eSpark-Backup/cwa-tracker-hw/Design-Files/Tracker-NB-IOT-PMIC-v1.1/Deliverables/_Renderings/2D_Top_View.png

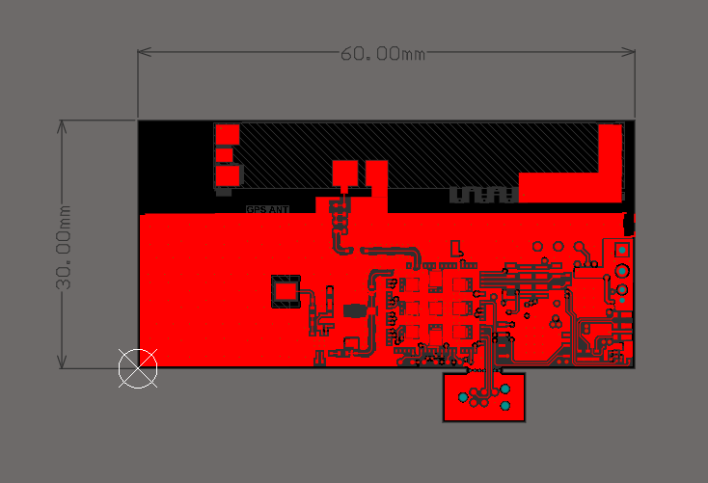
Design-Files/Tracker-NB-IOT-PMIC-v1.1/Deliverables/_Renderings/2D_Top_View.png
