eSpark-Backup/cwa-tracker-hw/Design-Files/Tracker-NB-IOT-PMIC-v1.1/Deliverables/_Renderings/3D_Isometric_View2.png

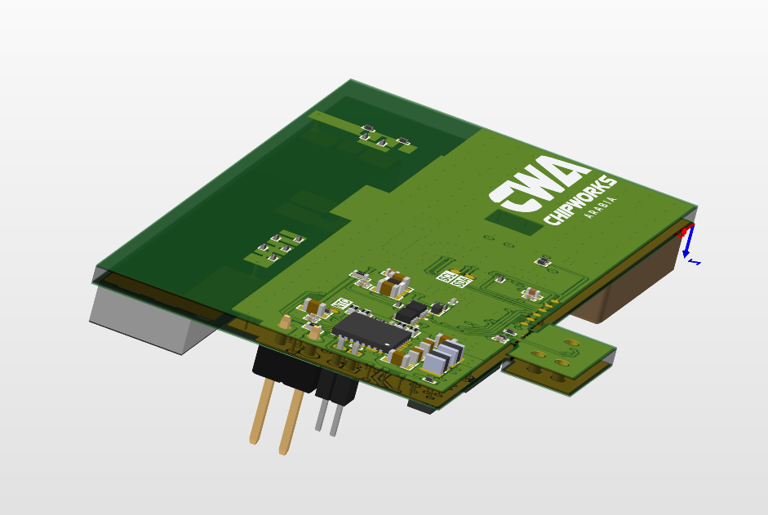
Design-Files/Tracker-NB-IOT-PMIC-v1.1/Deliverables/_Renderings/3D_Isometric_View2.png
