eSpark-Backup/cwa-tracker-hw/Design-Files/Tracker-NB-IOT-PMIC-v1.1/Deliverables/BOM/Tracker-NB-IOT-v1.1.xlsx

# | Item Type | Designator | Description | Footprint | Manufacturer Part Number | Manufacturer | Value | Quantity | Link | Remarks
1 | ANTENNA | A1 | GPS SMT PATCH ANTENNA | DSGP.1575.18.4.A.02 | DSGP.1575.18.4.C.02 | Taoglas | DSGP.1575.18.4.A.02 | 1
2 | RF Antennas | ANT1 | RF ANT 700MHZ/750MHZ FLAT BAR | P822601 | P822601 | AVX | P822601 | 1
3 | Capacitor | C1, C2, C3 | CAP CER 39PF 50V C0G/NPO 0402 | Cap-0402 | CC0402FRNPO9BN390 | Yageo | 39pF | 3
4 | Capacitor | C4, C5 | CAP CER 39PF 50V C0G/NPO 0402 | Cap-0402 | CC0402FRNPO9BN390 | Yageo | DNP | 2
5 | Capacitors | C6, C14 | CAP CER 100PF 50V C0G/NPO 0201 | CAP-0201 | CC0201GRNPO9BN101 | Yageo | 100pF | 2
6 | Capacitors | C7, C13, C17, C20, C21, C30, C31 | CAP CER 0.1UF 10V X5R 0201 | CAP-0201 | CC0201KRX5R6BB104 | Yageo | 100nF | 7
7 | Capacitor | C8, C9, C22, C23 | CAP CER 1UF 10V X5R 0201 | CAP-0201 | CC0201MRX5R6BB105 | Yageo | 1uF | 4
8 | Capacitor | C10, C11, C24, C25, C26, C28, C29 | CAP CER 10UF 10V X7R 0603 | Cap-0603 | GRM188Z71A106KA73D | Murata | 10uF | 7
9 | Capacitor | C12 | CAP CER 3.5PF 50V C0G/NP0 0201 | CAP-0201 | GJM0335C1H3R5BB01D | Murata | 3.5pF | 1
10 | Capacitors | C15, C16, C32 | CAP CER 56PF 25V C0G/NP0 0201 | CAP-0201 | GCM0335C1E560JA16D | Murata | DNP | 3
11 | Capacitors | C18, C19, C27 | CAP CER 4.7UF 10V X5R 0402 | Cap-0402 | CC0402KRX5R6BB475 | Yageo | 4.7uF | 3
12 | Ferrite Beads | FB1 | FERRITE BEAD 120 OHM 0402 1LN | IND-0402 | BLM15EX121SN1D | Murata | BLM15EX121SN1D | 1
13 | Ferrite Beads | FB2 | FERRITE BEAD 22 OHM 0603 1LN | IND-0603 (1608 Metric) | BLM18SD220SN1D | Murata | BLM18SD220SN1D | 1
14 | UFL Connector | J1 | CONN U.FL RCPT STR 50 OHM SMD | U.FL-R-SMT-1(80)_ | U.FL-R-SMT-1(80) | Hirose | U.FL-R-SMT-1(80) | 1
15 | RF / Coaxial Connectors | J2 | CONN SWF RCPT STR 50 OHM SMD | MM8130-2600RA2 | MM8130-2600RA2 | Murata | MM8130-2600RA2 | 1
16 | Male Header | J3 | Gold 250V 3A Straight Square Pins 2.5mm 2P 260℃ 6mm -40℃~+105℃ 3mm 2.54mm Plugin Black Brass 1x2P Plugin,P=2.54mm Pin Headers ROHS | HDR1X2_ | X6511WV-02H-C60D30 | XKB | X6511WV-02H-C60D30 | 1
17 |  | J4 |  | TC2030-IDC-NL_ |  |  | TC2030-IDC-NL | 1
18 | Pogo Connector | J5 | Pogo Pad 2.5mm 4 Pin | Pogo 4 Pin | POGO Connector 4 Pin |  | POGO Connector 4 Pin | 1
19 | Male | J6 | 3A Direct Insert Policy 1.7mm 2P 3mm -55℃~+105℃ 2.5mm 1.27mm Single Row Black Brass 1x2P Plugin,P=1.27mm Pin Headers ROHS | HDR 1x2 Male 1.27mm | 1.27-1*2P | BOOMELE(BOOM Precision Elec) | 1.27-1*2P | 1
20 | Inductor | L1 | FIXED IND 68NH 140MA 1.96OHM SMD | IND-0402 | LQW15AN68NG00D | Murata | 68nH | 1
21 | nductors | L2 | FIXED IND 9.1NH 540MA 0.14OHM SM | IND-0402 | LQW15AN9N1G00D | Murata | 9.1nH | 1
22 | Inductor | L3 | FIXED IND 1.5NH 1A 50 MOHM SMD | IND-0201 | LQP03HQ1N5B02D | Murata | 1.5nH | 1
23 | Inductors | L4 | FIXED IND 22NH 250MA 820MOHM SMD | IND-0201 | LQP03HQ22NH02D | Murata | 22nH | 1
24 | Inductor | L5, L6 | FIXED IND 2.2UH 2.5A 87MOHM SMD | IND-0806 | CIGT201610EH2R2MNE | Samsung | 2.2uH | 2
25 | LED | LED1 | LED GREEN CLEAR CHIP SMD | LED-0402 | XZVG68W-2 | SunLED | XZVG68W-2 | 1
26 | LED | LED2, LED3 | LED RED CLEAR CHIP SMD | LED-0402 | XZMDK68W-2 | SunLED | RED | 2
27 | MOSFETs | Q1 | MOSFET N/P-CH 20V SOT563 | SOT-563 | DMC2400UV-7 | Diodes | DMC2400UV-7 | 1
28 | MOSFETs | Q2 | MOSFET N-CH 20V 1A DFN1006-3 | DFN1006-3 | RV2C010UNT2L | Rohm | RV2C010UNT2L | 1
29 | Mosfet | Q3 | MOSFET 2N-CH 30V 0.5A SOT563 | SOT-563 | UM6X1NA-TP | MCC | UM6X1NA-TP | 1
30 | Resistor | R1, R5 | RES SMD 10K OHM 1% 1/20W 0201 | Res-0201 | RC0201FR-0710KL | Yageo | 10K | 2
31 |  | R2, R27 | RES SMD 0 OHM JUMPER 1/20W 0201 | Res-0201 | RC0201JR-070RL | Yageo | DNP | 2
32 | Resistors | R3, R20, R23, R25, R39 | RES 0 OHM JUMPER 1/16W 0402 | Res-0402 | RC0402FR-070RL | Yageo | 0R | 5
33 | Resistor | R4, R34 | RES 100K OHM 1% 1/20W 0201 | Res-0201 | RC0201FR-07100KL | Yageo | 100K | 2
34 | Resistors | R6, R7, R8, R9, R10, R11, R12, R13, R14, R24, R28, R33 | RES SMD 0 OHM JUMPER 1/20W 0201 | Res-0201 | RC0201JR-070RL | Yageo | 0R | 12
35 | Resistor | R15, R19 | RES 1K OHM 1% 1/20W 0201 | Res-0201 | RC0201FR-071KL | Yageo | 1K | 2
36 | Resistors | R16 | RES 0 OHM JUMPER 1/16W 0402 | Res-0402 | RC0402FR-070RL | Yageo | DNP | 1
37 | Resistors | R17, R18, R38 | RES 120 OHM 1% 1/16W 0402 | Res-0402 | RC0402FR-07120RL | Yageo | 120R | 3
38 | Resistor | R21, R22 | RES 1M OHM 1% 1/20W 0201 | Res-0201 | RC0201FR-071ML | Yageo | 1M | 2
39 | Resistor | R29 | RES SMD 47K OHM 0.1% 1/16W 0402 | Res-0402 | RT0402BRE0747KL | Yageo | 47K | 1
40 | Resistor | R30 | RES 150K OHM 0.1% 1/16W 0402 | Res-0402 | RT0402BRD07150KL | Yageo | 150K | 1
41 | Resistor | R31, R32, R35, R36 | RES 4.7K OHM 1% 1/20W 0201 | Res-0201 | RC0201FR-074K7L | Yageo | 4.7K | 4
42 | Switch | SW4 | SWITCH TACTILE SPST-NO 0.05A 12V | B3U-1000P | B3U-1000P | Omron | B3U-1000P | 1
43 | Module | U1 | GNSS Low-Noise Amplifier Front-End Module with Integrated Pre-Filter and Post-Filter | 10-MCM (2.5x2.5) | SKY65943-11 | Skyworks | SKY65943-11 | 1
44 | IC | U2 | IC RF TXRX + MCU CELL | NRF9151-LACA-R | NRF9151-LACA-R | Nordic Semiconductor | NRF9151-LACA-R | 1
45 | IC | U3 | IC FLASH 256MBIT SPI/QUAD 8WSON | 8-WSON (8x6) | GD25WB256EYIGY | GigaDevice | GD25WB256EYIGY | 1
46 | IC | U4 | E-SIM IC | MFFX | MFFX-M2M UICC | - | MFFX-M2M UICC | 1
47 | IC | U5 | PMIC (POWER MANAGEMENT IC) WITH | 32-QFN (5x5) | NPM1300-QEAA-R | Nordic Semiconductor | NPM1300-QEAA-R | 1
48 | Sensor | U6 | ACCEL 2-16G I2C/SPI 12LGA | 12-LGA (2x2) | LIS2DH12TR | STMicroelectronics | LIS2DH12TR | 1
49 | Peripheral | Battery | CP802860 | - | - | - | - | 1 | Battery (https://www.enhcb.com/uploads/file/cp802860-data-sheet-hcb20240529.pdf)
50 | Peripheral |  | TC2030-CTX 6-Pin Cable for ARM Cortex | - | - | - | - | 1 | Tag-Connect (https://www.tag-connect.com/product/tc2030-ctx-6-pin-cable-for-arm-cortex)
