eSpark-Backup/cwa-tracker-hw/docs/Dev-Files/Nordic nrf9151 DK/nRF9151 Development Kit - Hardware files 0_9_0/BOM/kit60004_BOM.xls

Bill of material
Kit: | KIT60004 - nRF9151 Development Kit
Version: | 0.9.0
Designator | Value | Description | Manufacturer | Manufacturer Part Number
Design | PCA10171 - nRF9151 Development Kit Board | Circuit board assembly
SIM card | SIM card | SIM card | Onomondo
SIM card | SIM card | SIM card | Wireless Logic
