eSpark-Backup/cwa-tracker-hw/docs/Dev-Files/Nordic nrf9151 DK/nRF9151 Development Kit - Hardware files 0_9_0/PCA10171-nRF9151 Development Board 0_9_0/Production files/BOM/PCA10171_BOM_Web.xls

Bill of Materials
Product Name: | nRF9151 Development Kit
Board: | PCA10171
Version: | 1.0.0
Creation Date: | 03/05/2024
Designator | Value | Description | Footprint Doc | Manufacturer | Manufacturer Part Number | #Column Name Error:' Fitted | Quantity
A1 | P822601 | ANTENNA PRESTTA OCTABAND LTE | P822601 | Ethertronics | P822601 |  | 1
A2 | DSGP.1575.18 | 18 x 18 mm Low Profile GPS L1 / GALILEO E1 Passive Patch Antenna | DSGP.1575.18.4.C.02 | Taoglas | DSGP.1575.18.4.C.02 |  | 1
C1, C2 | 1.0µF | Capacitor, X5R, ±20%, 10V | 0201 | Murata | GRM033R61A105ME15 |  | 2
C3, C7 | 10µF | Capacitor, Ceramic, 10µF 10V X6S 0603,±20% | 0603 | Murata | GRM188C81A106MA73 |  | 2
C4, C10, C15, C24, C25, C26, C27, C31, C32, C33, C34, C39, C42, C43, C51, C52_S1, C52_S2, C52_S3, C52_S4, C52_S5, C52_S6, C52_S8, C52_S10, C52_S11, C53_S7, C53_S9, C62 | 100nF | Capacitor, X5R, ±10% | 0201 | N.A. | N.A. |  | 27
C5, C6 | 4.7µF | Capacitor, X5R, 10V | 0402 | Murata | GRM155R61A475MEAAD |  | 2
C11, C12, C13 | 39pF | Capacitor, NP0, ±1%, 25V | 0201 | Murata | GRM0335C1E390FA01 |  | 3
C14, C17 | 100pF | Capacitor, NP0, ±2%, 25V | 0201 | Murata | GRM0335C1E101GA01 |  | 2
C20 | 3.5pF | Capacitor, NP0, ±0.1pF, 25V | 0201 | Murata | GJM0335C1H3R5BB01E |  | 1
C28, C29, C35, C36, C40 | 1.0µF | Capacitor, Ceramic, X5R, ±10%, 10V | 0402 | N.A. | N.A. |  | 5
C30 | 2.2nF | Capacitor, X7R, ±10%, 10V | 0201 | N.A. | N.A. |  | 1
C37, C38, C58 | 4.7µF | Capacitor, Ceramic, X5R, ±10%, 10V | 0603 | N.A. | N.A. |  | 3
C41, C48, C50 | 10nF | Capacitor, X7R, ±10% | 0201 | N.A. | N.A. |  | 3
C44, C45, C46, C47 | 1.0µF | Capacitor, X5R, ±10% | 0201 | N.A. | N.A. |  | 4
C54 | 1.0µF | Capacitor, Ceramic, 1.0µF 10V X5R 0603,±10% | 0603 | N.A. | N.A. |  | 1
C55, C56, C57, C59, C60 | 10µF | Capacitor, X7T, ±20%, 10V | 0603 | Murata | GRM188D71A106MA73 |  | 5
D1, D2, D3, D4 | CFSH05-20L | DIODE SCHOTTKY 20V 500MA SOD882 | SOD-882L | Central Semiconductor Corp. | CFSH05-20L |  | 4
D5 | TPD3F303DPVR | ESD Protection and EMI Filter for SIM Card Interface | USON-8 | Texas Instruments | TPD3F303DPVR |  | 1
D6 | PRTR5V0U2X | Ultra low capacitance double rail-to-rail ESD protection diode | SOT-143B | NXP Semiconductors | PRTR5V0U2X |  | 1
FB1 | 22R@100M/6A | Ferrite Bead, 22 Ohm @ 100MHz, 6000mA, 8 mOhm Max | 0603 | Murata | BLM18SD220SN1D |  | 1
FB2 | 120R/0.55A | Ferrite Bead, 120 Ohm @ 100MHz, 500mA, 250 mOhm Max | 0402 | Murata | BLM15AG121SN1D |  | 1
FB3 | 120R/1.2A | Ferrite Bead, 120 Ohm @ 100MHz, 1200mA, 75 mOhm Max | 0402 | Murata | BLM15EX121SN1 |  | 1
J1 | MM8130-2600 | Coaxial Connector with Switch | COAXIAL-SWF | Murata | MM8130-2600 |  | 1
J2 | MHF I Receptacle | Ultraminiature Coaxial Connector, 50 Ohm, SMD | COAXIAL RF MHFI | Wellshow | 20279-001E-03 |  | 1
J5 | KLS1-SIM-066 | Nano SIM Card Connector, Push-Push, 6-Pin, H1.37mm, with CD Pin | KLS1-SIM-066 | KLS Electronic | L-KLS1-SIM-066-(6+1)P-H1.37-R |  | 1
J6 | USB-C 2.0 | USB-C Receptacle, 16 Pin, USB 2.0 | SD-80259-001 | Bellweather Electronic Corp. | 80259-1021 |  | 1
L1 | 1.5nH | Inductor, 1000mA, ±0.1ｎH, 50mOhm | 0201 | Murata | LQP03HQ1N5B02 |  | 1
L2 | 22nH | Chip Inductor | 0201 | N.A. | N.A. |  | 1
L3 | 68nH | Inductor, 140mA, ±2%, 1960mΩ, Q=20 | 0402 | Murata | LQW15AN68NG00 |  | 1
L6 | 9.1nH | Inductor, 540mA, ±2%, 140mΩ, Q=25 | 0402 | Murata | LQW15AN9N1G00 |  | 1
L7, L8 | 2.2µH | Inductor, Irms=2.5A, Isat=2.9A, ±20%, DCR=73mΩ | 0806 | Samsung Electro-Mechanics America | CIGT201610EH2R2MNE |  | 2
LABEL1 | 15x40mm | PCA version label, stick-on, 15x40mm | Label | Ellco Etikett | 51945 |  | 1
LED1, LED2, LED3, LED4, LED5 | L0603G | LED, Green, 0603, 573nm, Vf=2.0V, 24mcd, - 40 to +85°C | 0603 | Victory Electronics | VS 25C7M5 |  | 5
M1 | nRF9151-LACAA0A | Low power System-in-Package with integrated LTE-M/NB-IoT modem and GPS | LGA-113 | Nordic Semiconductor | nRF9151-LACAA0A |  | 1
P1, P3, P6 | Socket 1x8 | Socket 1x8, 2.54mm (100mil), SMD | SOCKET_1x8_SMD | WCON | 2171-108MS0CUNR1 |  | 3
P2 | Socket 1x6 | Socket 1x6, 2.54mm (100mil), SMD | SOCKET_1x6_SMD | WCON | 2171-106MS0CUNR1 |  | 1
P4 | Socket 1x10 | Socket 1x10, 2.54mm (100mil), SMD | SOCKET_1x10_SMD | WCON | 2171-110MS0CUNR1 |  | 1
P5 | Pin Hdr 2x3 | Pin Header 2x3, 2.54mm (100mil) SMD | HDR_2x3-SMD | WCON | 1125-1203S0M116R1 |  | 1
P18, P19 | Pin Header 2x5, 1.27mm | Pin Header 2x5, 1.27mm (50mil), SMD, Keying Shroud | HDR_2x5-SMD-1.27mm | WCON | 3132-10MS0BK00R1 |  | 2
P20 | Pin List 1x13 | Pin List 1x13, 2.54mm (100mil), SMD | LIST_1x13_SMD | N.A. | N.A. |  | 1
P22 | Pin List 1x4, Angled | Pin List 1x4, 2.54mm (100mil), Right Angled, SMD | LIST_ANG_1x4-SMD-2.54MM | WCON | 1125B-1104S0Z135CR02 |  | 1
P24 | Socket 2x6 | Socket 2x6, 2.54mm (100mil), SMD | SOCKET_2x6_SMD-2.54mm | WCON | 2171-206MS0CUNR1 |  | 1
P25 | Pin Header 2x10, 1.27mm, SWD | Pin Header 2x10, 1.27mm (50mil), SMD, Keying Shroud, Removed Pin 7 | HDR_2x10-SMD-1.27mm-SWD | WCON | 3132-20MS0BK00R3 |  | 1
P28 | Pin Header 2x5, 1.27mm | Pin Header 2x5, 1.27mm (50mil), SMD | HDR_2x5-SMD-1.27mm | WCON | 1325-1205S0M078R1 |  | 1
P30 | Pin List 1x2, Angled | Pin List 1x2, 2.54mm (100mil), Right Angled, SMD | LIST_ANG_1x2-SMD-2.54MM | WCON | 1125B-1102S0Z135R2 |  | 1
Q1, Q7 | DMC2400UV | Dual N & P Ch MOFET, 1.03A/0.7A, 480mOhm, 450mW | SOT-563 | Diodes Incorporated | DMC2400UV |  | 2
Q2, Q3, Q6 | RV2C010UNT2L | N-Channel MOSFET, 20V, 1A, 470mOhm, 400mW | DFN-3 | Rohm Semiconductor | RV2C010UNT2L |  | 3
Q4, Q5 | UM6X1NA | Dual N-Channel MOSFET, Vds = 30V, Vgs(th) = 1.5V, Id = 0.5A, Rds = 750mOhm, Pd = 150mW | SOT-563 | Micro Commercial Components | UM6X1NA-TP |  | 2
Q8, Q9 | MCM2301 | Dual P-Channel MOFET, 3.8A, 90mOhm max, 1.4W | VDFN-6 | Micro Commercial Components | MCM2301 |  | 2
R1, R8, R77, R79 | 10k | Resistor, ±1%, 0.05W | 0201 | N.A. | N.A. |  | 4
R2, R6 | 1k | Resistor, ±1%, 0.05W | 0201 | N.A. | N.A. |  | 2
R3, R7, R13, R14, R17, R18, R24, R31, R32, R38, R43, R44, R45, R46, R47, R62, R66, R67, R69, R72, R73, R75, R80 | 1M0 | Resistor, ±1%, 0.05W | 0201 | N.A. | N.A. |  | 23
R4 | 0R | Resistor, ±5%, 0.063W | 0402 | N.A. | N.A. |  | 1
R10, R34, R35, R52, R54, R56, R60, R63, R64, R65, R76, R81, R85, R86 | 100k | Resistor, ±1%, 0.05W | 0201 | N.A. | N.A. |  | 14
R11, R12, R15, R16, R19, R20, R22, R25, R26, R27, R28, R29, R30 | 150R | Resistor, ±1%, 0.05W | 0201 | N.A. | N.A. |  | 13
R21 | 2R2 | Resistor, ±1%, 0.05W | 0201 | N.A. | N.A. |  | 1
R33, R39, R40, R41, R42 | 120R | Resistor, ±1%, 0.05W | 0201 | N.A. | N.A. |  | 5
R36, R74 | 47k | Resistor, ±1%, 0.05W | 0201 | N.A. | N.A. |  | 2
R37, R78 | 150k | Resistor, ±1%, 0.05W | 0201 | N.A. | N.A. |  | 2
R48, R49, R83, R84 | 4k7 | Resistor, ±1%, 0.05W | 0201 | N.A. | N.A. |  | 4
R50, R51 | 12k | Resistor, ±1%, 0.05W | 0201 | N.A. | N.A. |  | 2
R53, R55, R57, R61 | 18k | Resistor, ±1%, 0.05W | 0201 | N.A. | N.A. |  | 4
R58, R87 | 0R | Resistor, ±5%, 0.05W | 0201 | N.A. | N.A. |  | 2
R68 | 1k87 | Resistor, ±1%, 0.05W | 0201 | N.A. | N.A. |  | 1
R70, R71 | 5k1 | Resistor, ±1%, 0.05W | 0201 | N.A. | N.A. |  | 2
SW1, SW2, SW3, SW4, SW5 | PB SW | Tactile Switch, SPNO, SMD, 160gf, 6.2x6.4x2.5mm | L-KLS7-TS6616B-2.5-160-T | KLS | L-KLS7-TS6616B-2.5-160-T |  | 5
SW6 | Switch | SMD slide Switch (ON-ON) | Switch-Slide-RA-J-Lead-DPDT-8.5x3.5mm | C&K | JS202011JAQN |  | 1
U2 | SKY65943-11 | GNSS Low-Noise Amplifier Front-End Module with Integrated Pre-Filter and Post-Filter | MCM-10 | Skyworks | SKY65943-11 |  | 1
U3 | nRF5340-QKAA | Multi-protocol Bluetooth Low Energy, IEEE 802.15.4, ANT and 2.4GHz proprietary system-on-chip | AQFN-98 | Nordic Semiconductor | nRF5340-QKAAD0 |  | 1
U4 | GD25WB256E | Quad Serial Flash, 256Mbit, 104MHz, 1.65V - 3.6V | WSON-8 | GigaDevice | GD25WB256EYIG |  | 1
U5 | PCAL6408A | 8-bit I2C-bus I/O expander with interrupt output | XQFN-16 | NXP Semiconductors | PCAL6408AHK |  | 1
U7_S1, U7_S2, U7_S3, U7_S4, U7_S5, U7_S6, U7_S8, U7_S10, U7_S11 | FSA2466UMX | Data / Audio Low-Voltage Dual DPDT Analog Switch | UFQFN-16 | ON Semiconductor | FSA2466UMX |  | 9
U8_S7, U8_S9 | NX3DV2567 | Low-ohmic four-pole double-throw analog switch | XQFN-16 | NXP Semiconductors | NX3DV2567GU |  | 2
U9 | nPM1300-QEAA | Li-Ion/Li-Polymer USB-C battery charger with high efficiency buck regulators, LDOs or load switches, LED drivers, TWI and VBUSOUT | QFN-32 | Nordic Semiconductor | nPM1300-QEAA |  | 1
X1 | 32MHz | XTAL SMD 2016, 32MHz, Cl=8pF, Tot: ±40ppm | XTAL_2016 | Kyocera | CX2016DB32000D0WZRC1 |  | 1
Y1 | Shunt 2.54mm | Shunt Jumper 2.54mm Black | SHUNT JUMPER 2.54mm | 3M | 969102-0000-DA |  | 1
Y2 | Shunt 2.54mm | Shunt Jumper 2.54mm Black | SHUNT JUMPER 2.54mm | 3M | 969102-0000-DA |  | 1
 |  |  |  |  |  |  | 219
