eSpark-Backup/cwa-tracker-hw/Design-Files/Tracker-NB-IOT-PMIC-v1.1/Deliverables/_Supporting Files/Tracker-NB-IOT-v1.1.step

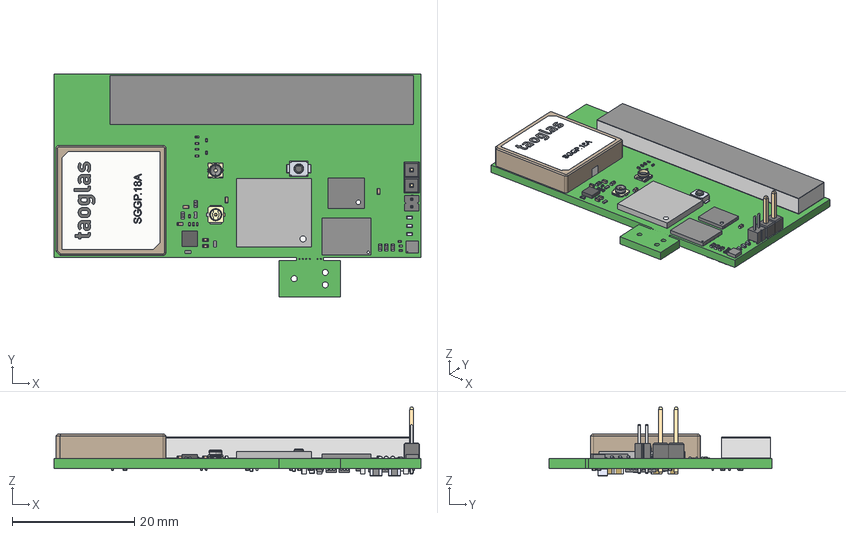
[picture p10: CAD file, 2024-10-18]
Design-Files/Tracker-NB-IOT-PMIC-v1.1/Deliverables/_Supporting Files/Tracker-NB-IOT-v1.1.step
60.0 x 36.5 x 11.3 mm
User Library-SMD Ceramic Capacitors_0201 (0603)_AB x 17
LIS2DW12TR
User Library-OMRON B3U1000P
User Library-RES_1005-0402 x 11
User Library-0201(0603M) Res x 26
User Library-LED-0402 x 3
1286AS-H-R47M=P2 x 2
User Library-CAPC1608X09 x 7
User Library-Capacitor 0402 x 8
TCA6424ARGJR
W25Q256JVEIQ TR--3DModel-STEP-269445
Thermal_Shape
Extruded x 2
SOT_X-T1-GE3_VIS x 2
MMBT3904LP-7--3DModel-STEP-56544
Ferrite x 2
User Library-d0402h025 x 3
User Library-Header1x2_Header1_1 x 2
MM8130-2600RA2
U.FL-R-SMT-1
Lötende x 2
base
P822601--3DModel-STEP-56544
SGGP.18A v5
