eSpark-Backup/cwa-tracker-hw/(list of files, cad)

Other CAD files:
Design-Files/Tracker-NB-IOT-PMIC-v1.1/Deliverables/_Supporting Files/Tracker-NB-IOT-v1.1.DWG
Design-Files/Tracker-NB-IOT-PMIC-v1.1/Deliverables/_Supporting Files/Tracker-NB-IOT-v1.1.DXF
