eSpark-Backup/cwa-tracker-hw/Design-Files/Tracker-NB-IOT-PMIC-v1.1/Schematic/Tracker-NB-IOT-v1.1.pdf

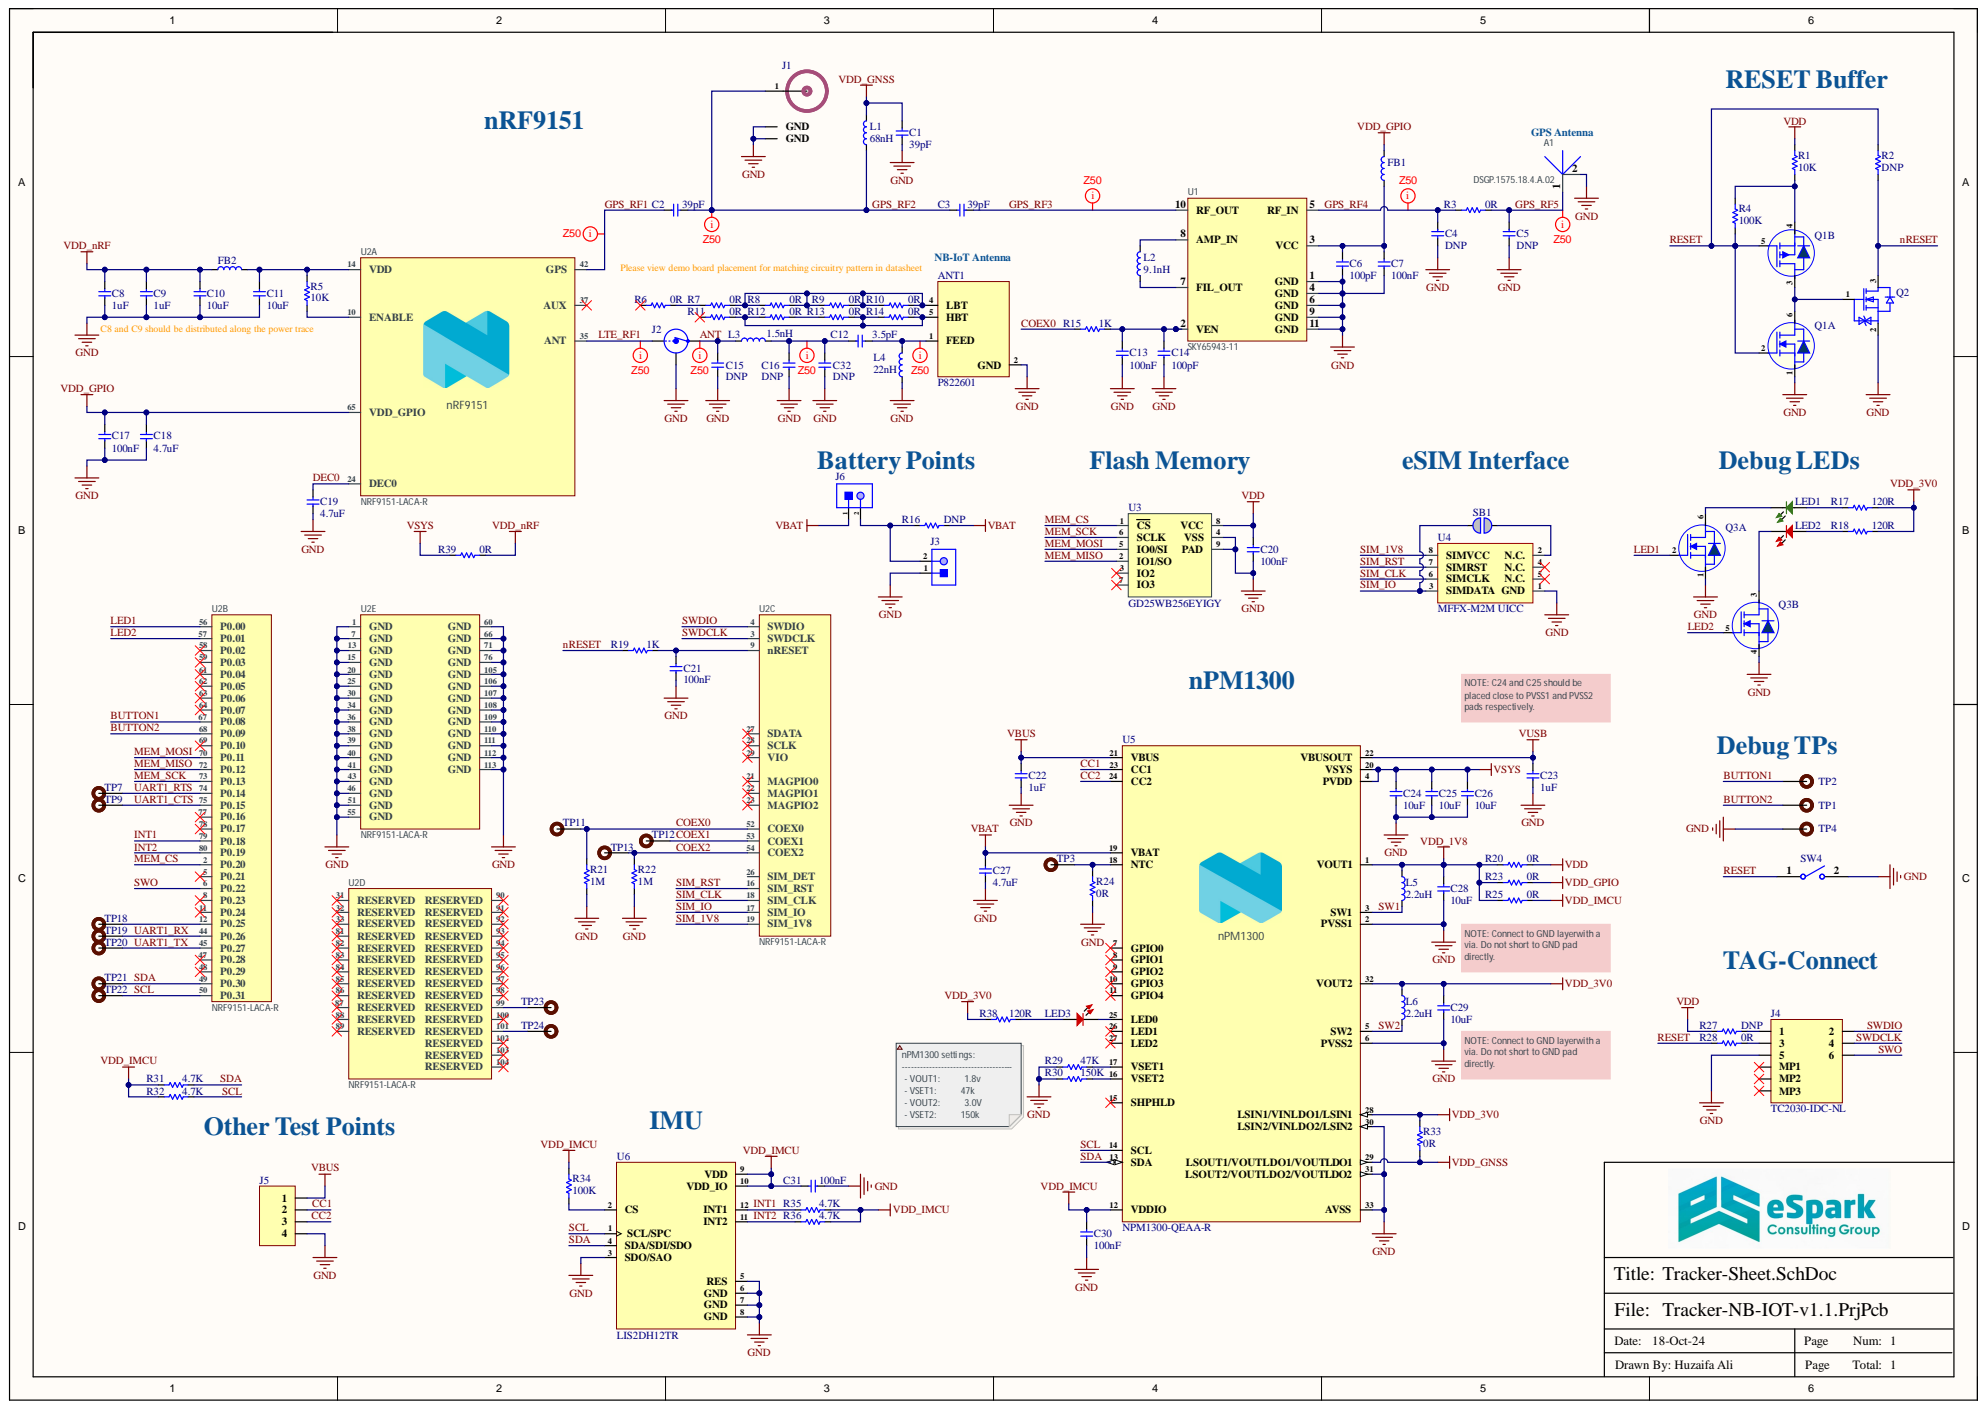
[picture p11: page 1]

C8 and C9 should be distributed along the power trace

NOTE: C24 and C25 should be
placed close to PVSS1 and PVSS2
pads respectively.

NOTE: Connect to GND layerwith a
via. Do not short to GND pad
directly.

Tracker-NB-IOT-v1.1.PrjPcb

Date: 18-Oct-24 | Page Num: 1

Drawn By: Huzaifa Ali | Page Total: 1
