eSpark-Backup/cwa-tracker-hw/Design-Files/Tracker-NB-IOT-Boost-v1.0/Schematic/Tracker-NB-IOT-v1.0.pdf

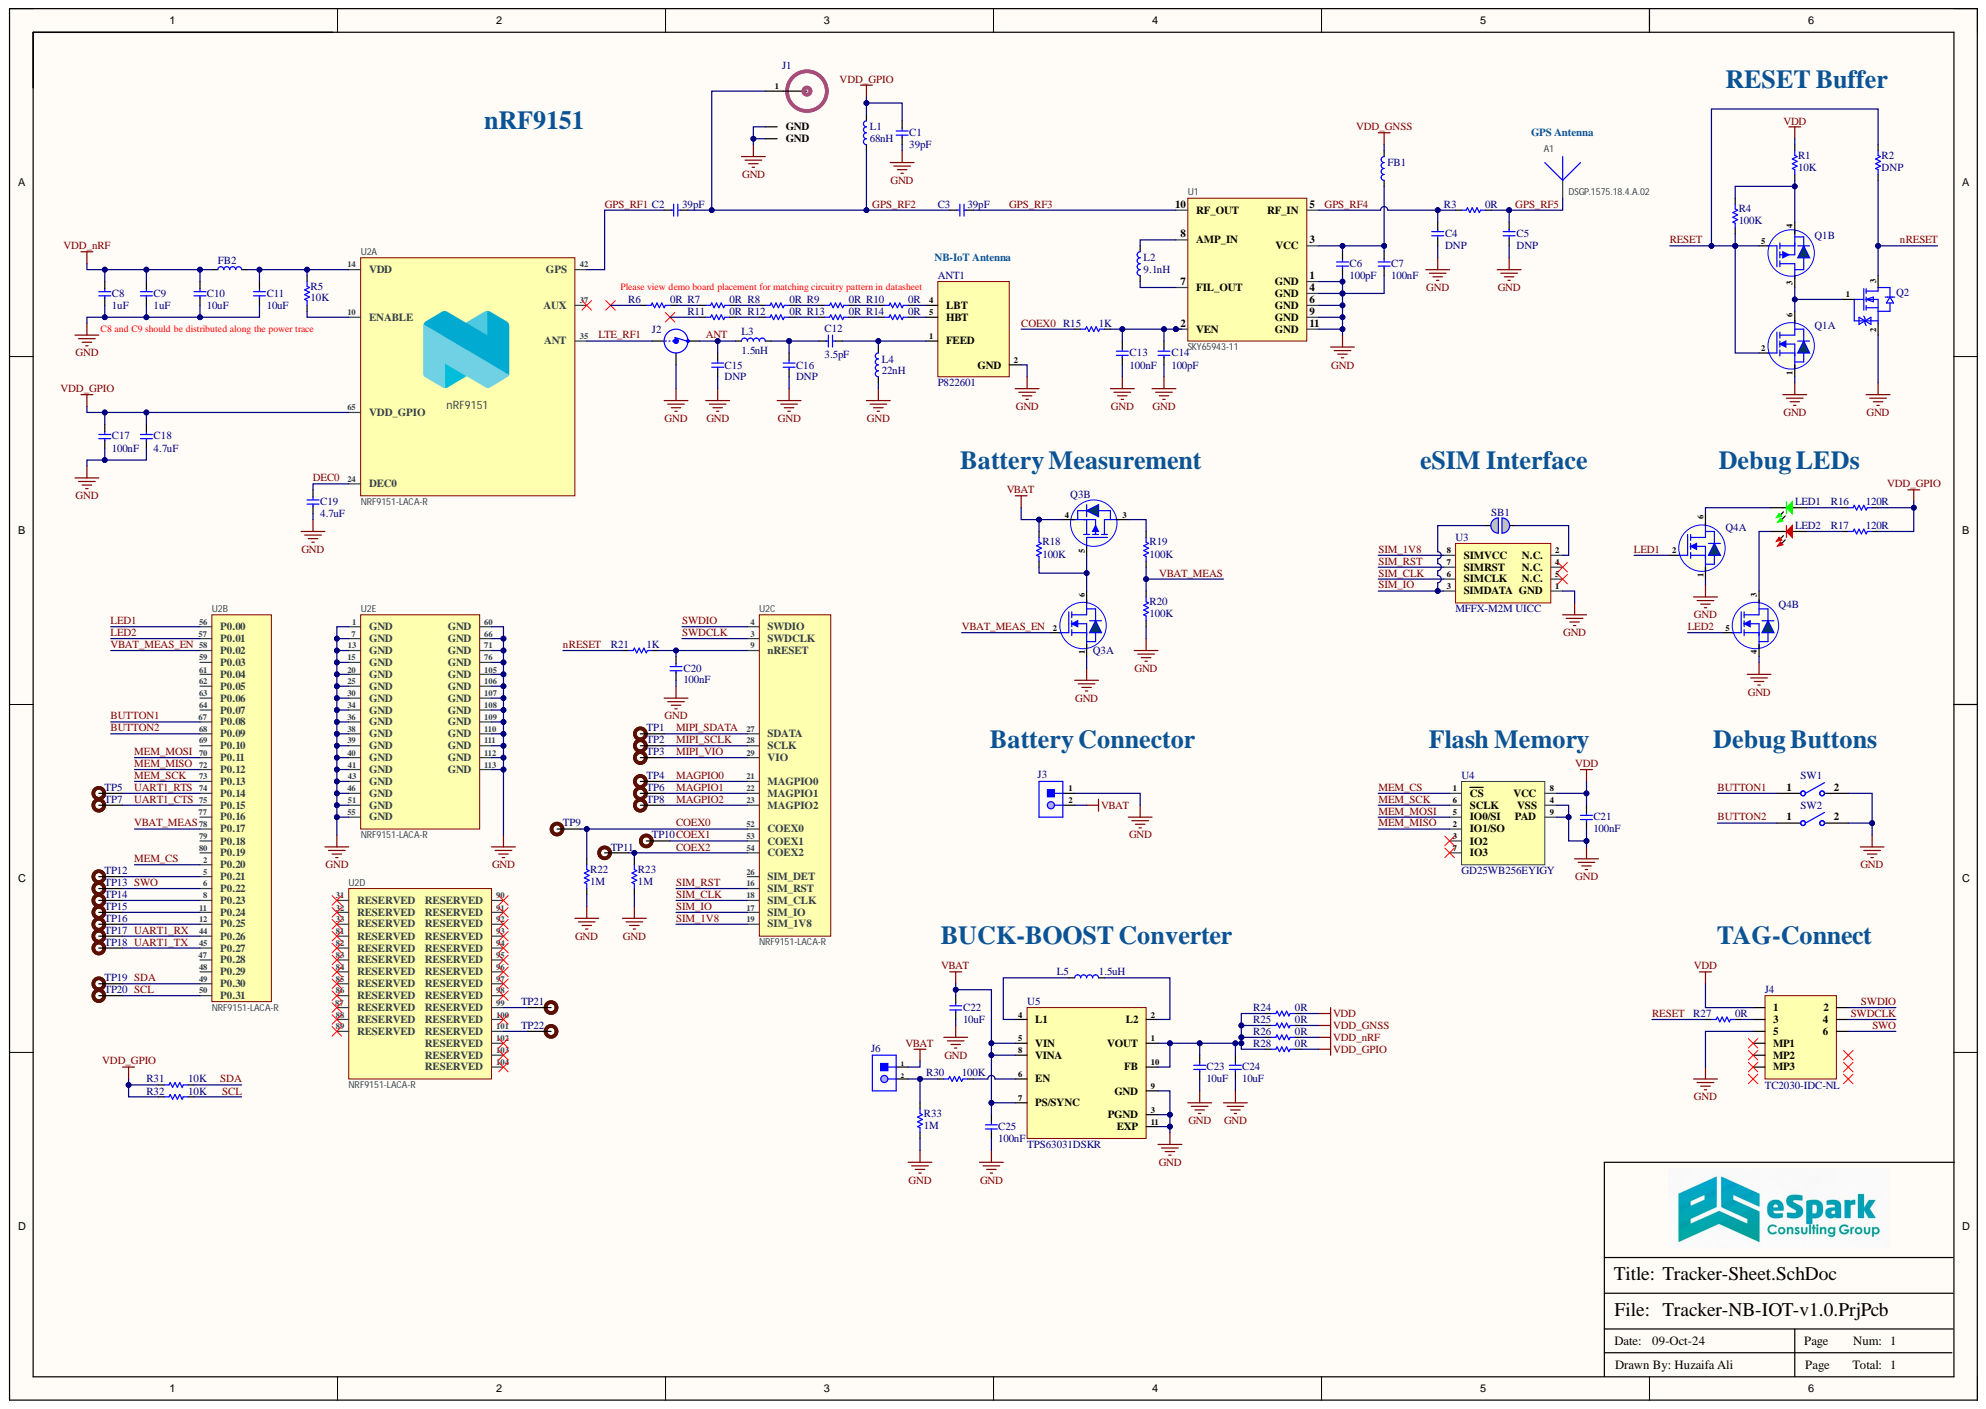
[picture p12: page 1]

Please view demo board placement for matching circuitry pattern in datasheet

C8 and C9 should be distributed along the power trace

Tracker-NB-IOT-v1.0.PrjPcb

Date: 09-Oct-24 | Page Num: 1

Drawn By: Huzaifa Ali | Page Total: 1
