eSpark-Backup/cwa-tracker-hw/Design-Files/Tracker-NB-IOT-PMIC-v1.1/Deliverables/_Schematics/Assembly Drawing.pdf

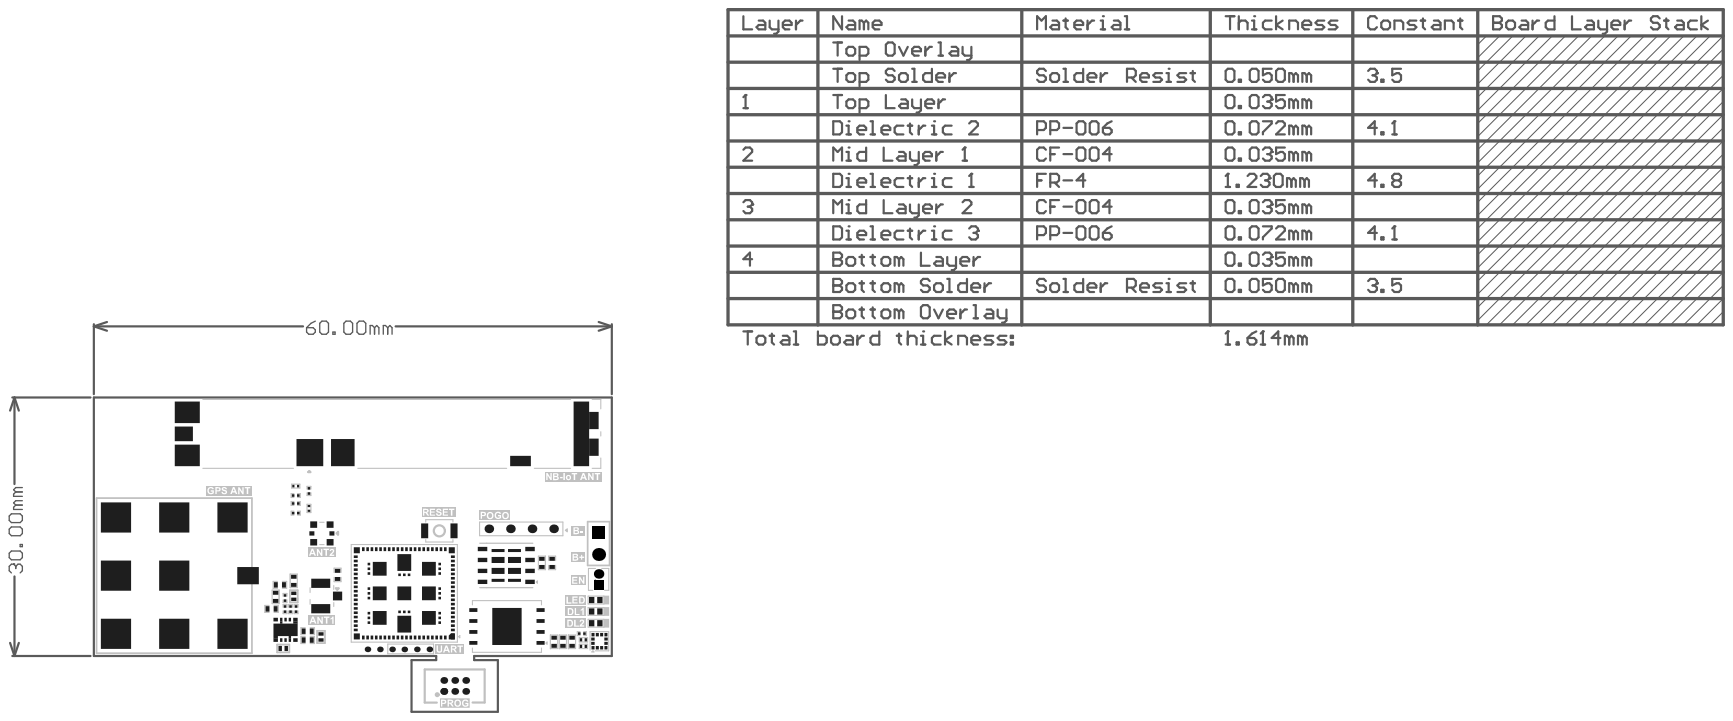
[picture p13: page 1]

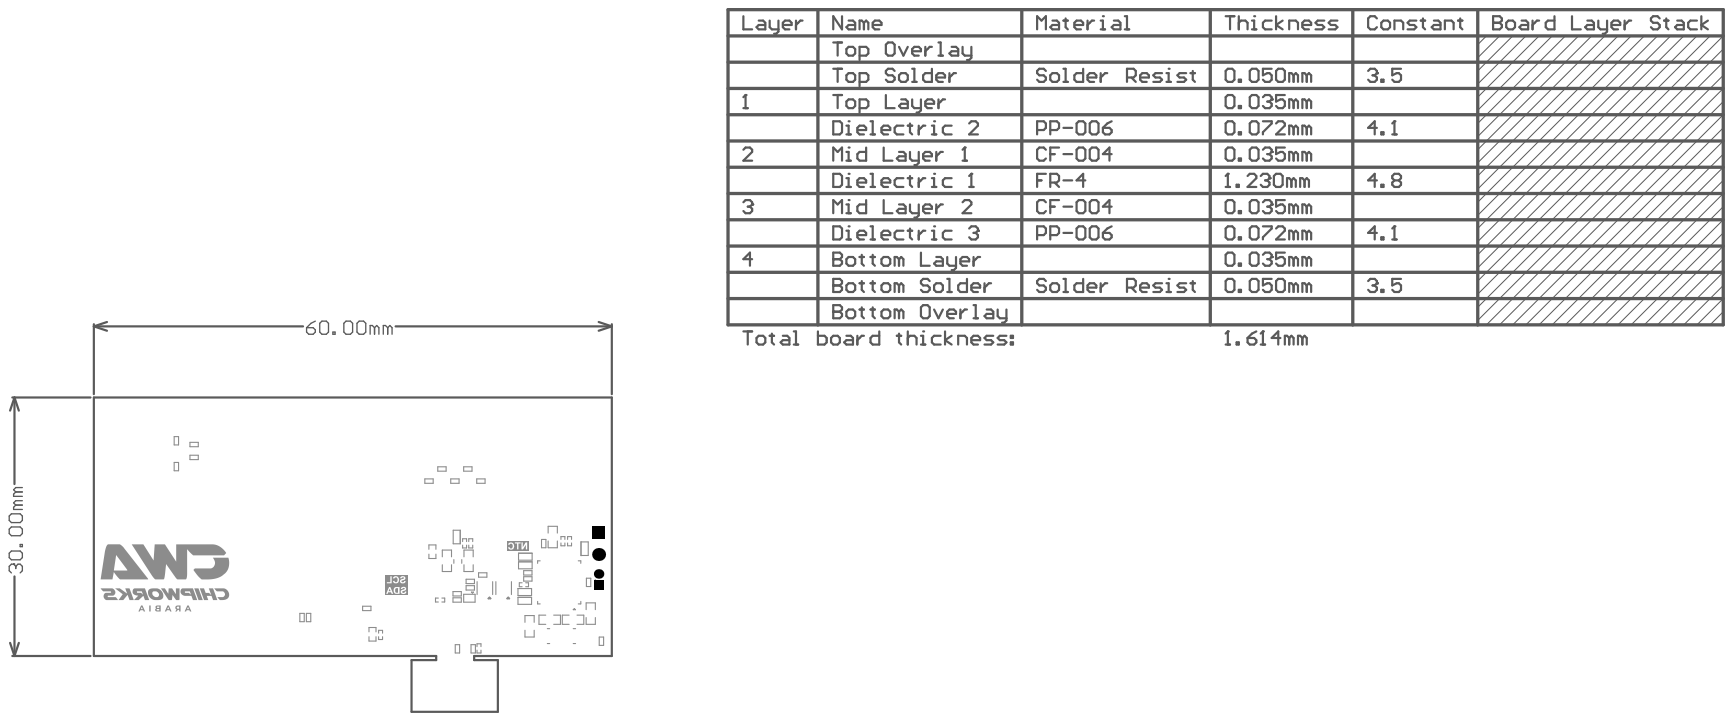
[picture p14: page 2]

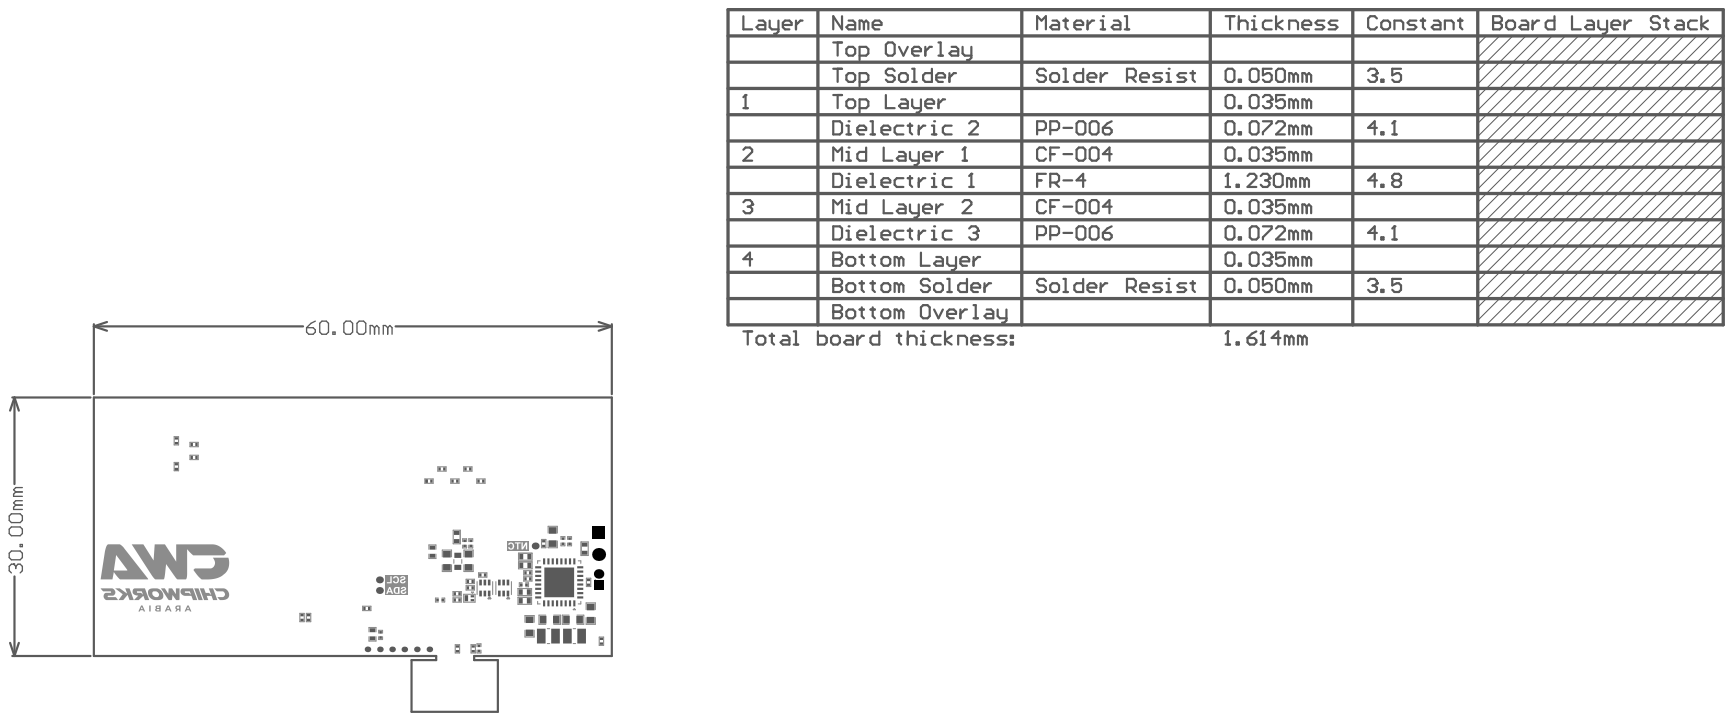
[picture p15: page 4]
