eSpark-Backup/cwa-tracker-hw/docs/Dev-Files/Nordic nrf9151 DK/nRF9151 Development Kit - Hardware files 0_9_0/PCA10171-nRF9151 Development Board 0_9_0/Production files/ASSEMBLY/400797_Assembly_Drawing.pdf

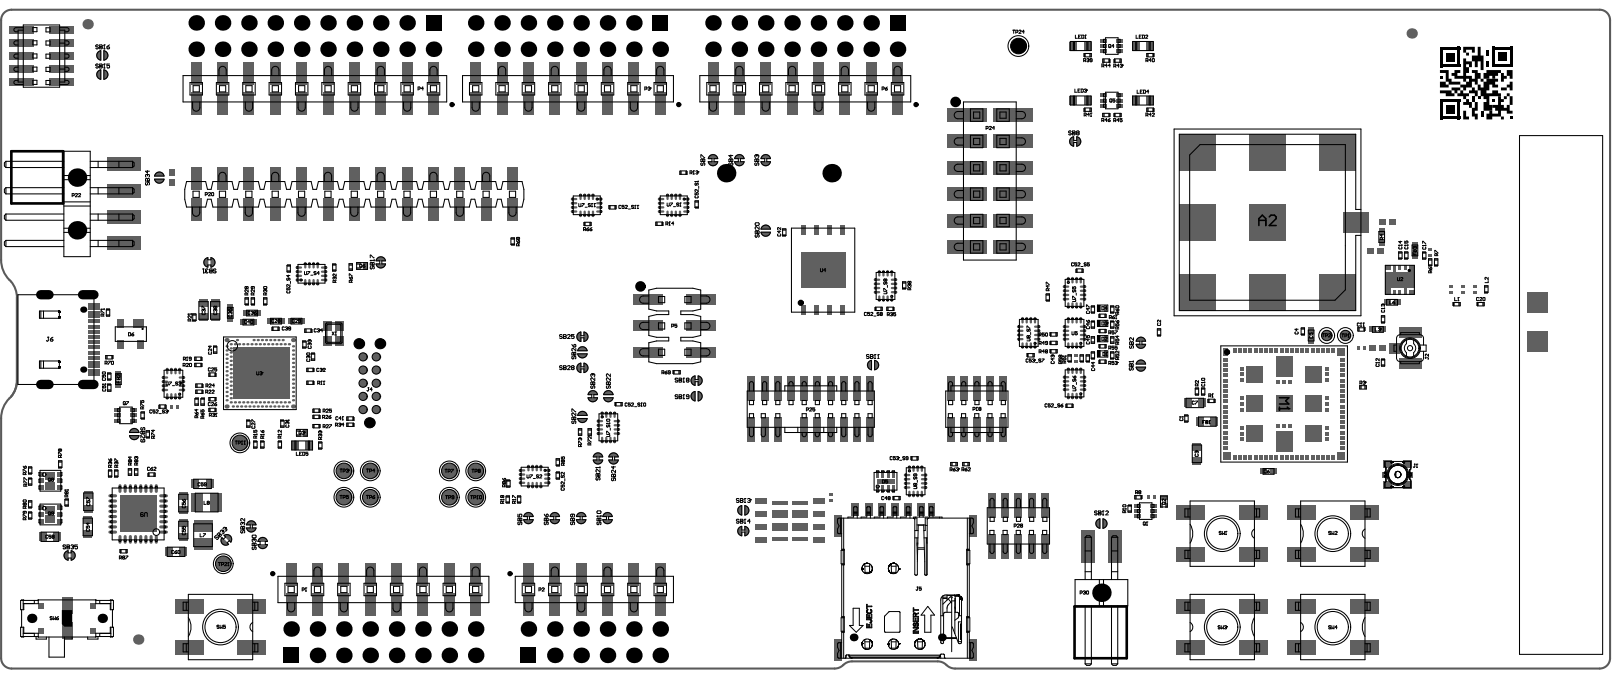
[picture p16: page 1]

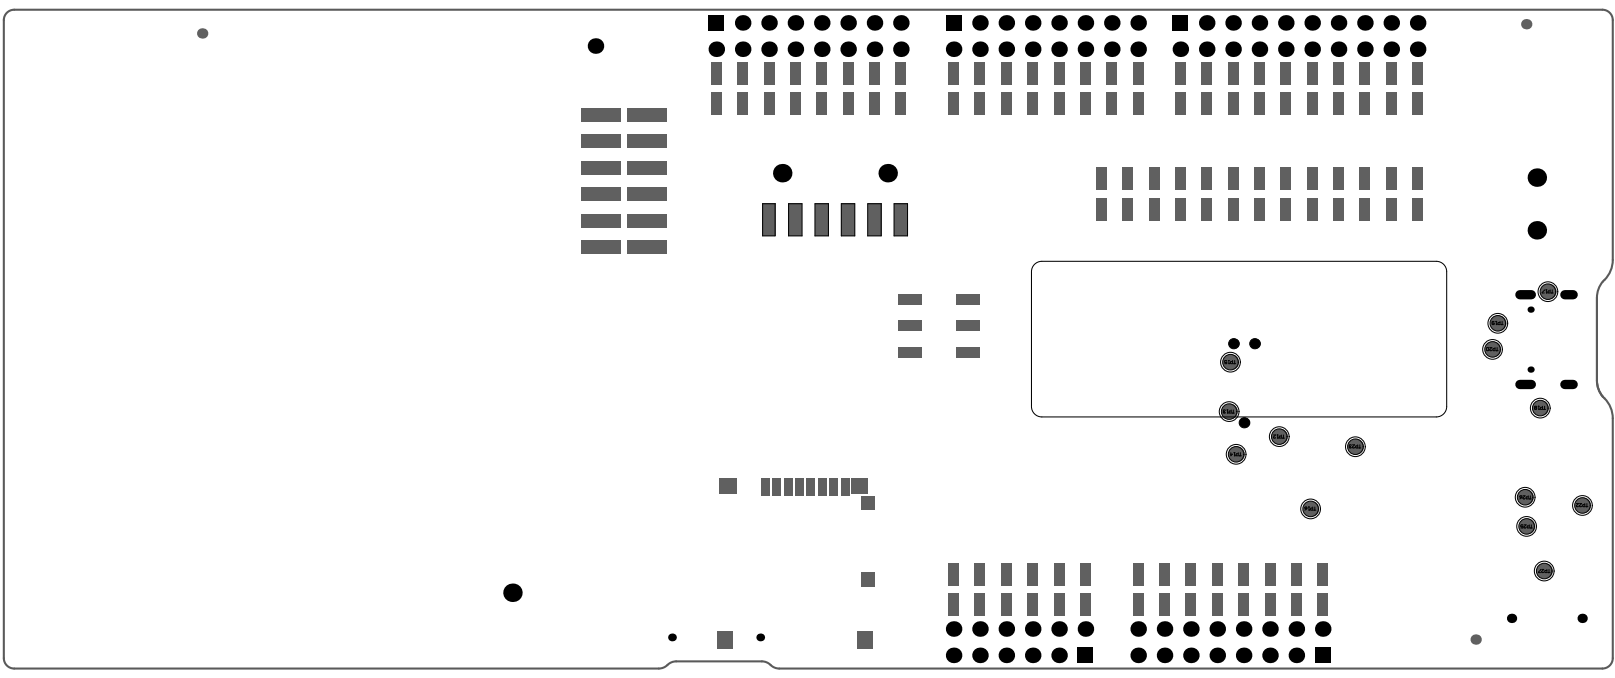
[picture p17: page 2]
