eSpark-Backup/cwa-tracker-hw/(list of files, drawings)

Other design files:
Design-Files/Tracker-NB-IOT-Boost-v1.0/Tracker-NB-IOT-v1.0.PcbDoc
Design-Files/Tracker-NB-IOT-Boost-v1.0/Tracker-NB-IOT-v1.0.PrjPcb
Design-Files/Tracker-NB-IOT-Boost-v1.0/Tracker-Sheet.SchDoc
Design-Files/Tracker-NB-IOT-PMIC-v1.1/Tracker-NB-IOT-v1.1.PcbDoc
Design-Files/Tracker-NB-IOT-PMIC-v1.1/Tracker-NB-IOT-v1.1.PrjPcb
Design-Files/Tracker-NB-IOT-PMIC-v1.1/Tracker-Sheet.SchDoc
docs/Dev-Files/Nordic nrf9151 DK/nRF9151 Development Kit - Hardware files 0_9_0/PCA10171-nRF9151 Development Board 0_9_0/Altium Designer files/400797.PcbDoc
docs/Dev-Files/Nordic nrf9151 DK/nRF9151 Development Kit - Hardware files 0_9_0/PCA10171-nRF9151 Development Board 0_9_0/Altium Designer files/pca10171.PrjPCB
docs/Dev-Files/Nordic nrf9151 DK/nRF9151 Development Kit - Hardware files 0_9_0/PCA10171-nRF9151 Development Board 0_9_0/Altium Designer files/pca10171_connectors.SchDoc
docs/Dev-Files/Nordic nrf9151 DK/nRF9151 Development Kit - Hardware files 0_9_0/PCA10171-nRF9151 Development Board 0_9_0/Altium Designer files/pca10171_interface_mcu.SchDoc
docs/Dev-Files/Nordic nrf9151 DK/nRF9151 Development Kit - Hardware files 0_9_0/PCA10171-nRF9151 Development Board 0_9_0/Altium Designer files/pca10171_io_expander.SchDoc
docs/Dev-Files/Nordic nrf9151 DK/nRF9151 Development Kit - Hardware files 0_9_0/PCA10171-nRF9151 Development Board 0_9_0/Altium Designer files/pca10171_leds_and_buttons.SchDoc
docs/Dev-Files/Nordic nrf9151 DK/nRF9151 Development Kit - Hardware files 0_9_0/PCA10171-nRF9151 Development Board 0_9_0/Altium Designer files/pca10171_memory.SchDoc
docs/Dev-Files/Nordic nrf9151 DK/nRF9151 Development Kit - Hardware files 0_9_0/PCA10171-nRF9151 Development Board 0_9_0/Altium Designer files/pca10171_nrf9151.SchDoc
docs/Dev-Files/Nordic nrf9151 DK/nRF9151 Development Kit - Hardware files 0_9_0/PCA10171-nRF9151 Development Board 0_9_0/Altium Designer files/pca10171_power_supply.SchDoc
docs/Dev-Files/Nordic nrf9151 DK/nRF9151 Development Kit - Hardware files 0_9_0/PCA10171-nRF9151 Development Board 0_9_0/Altium Designer files/pca10171_switch_fsa.SchDoc
docs/Dev-Files/Nordic nrf9151 DK/nRF9151 Development Kit - Hardware files 0_9_0/PCA10171-nRF9151 Development Board 0_9_0/Altium Designer files/pca10171_switch_nx.SchDoc
docs/Dev-Files/Nordic nrf9151 DK/nRF9151 Development Kit - Hardware files 0_9_0/PCA10171-nRF9151 Development Board 0_9_0/Altium Designer files/pca10171_top_level.SchDoc
