eSpark-Backup/cwa-tracker-hw/(commit log)

2024-10-08 #1 1st schematic draft complete
    [400797.DRL, 400797.GBL, 400797.GBO, 400797.GBP, 400797.GBS, 400797.GM1, 400797.GTL, 400797.GTO]
2024-10-09 #1 Note added.
    [Tracker-Sheet.SchDoc]
2024-10-09 #1 Folder names changed
    [Tracker-NB-IOT-v1.0.PrjPcb, Tracker-NB-IOT-v1.1.PrjPcb, Tracker-Sheet.SchDoc]
2024-10-09 #1 TAG connect changed to TC2030. SWD removed. PDF Updated
    [Tracker-Sheet.SchDoc]
2024-10-11 #2 Placement Completed
    [Tracker-NB-IOT-v1.0.PcbDoc, Tracker-NB-IOT-v1.0.PrjPcb, Tracker-Sheet.SchDoc]
2024-10-14 #1 PMIC v1.1 design - nPM1300, charger, IMU added
    [Tracker-Sheet.SchDoc]
2024-10-14 #1 PMIC design v1.1 - PDF generated
    [Tracker-NB-IOT-v1.1.PrjPcb, Tracker-Sheet.SchDoc]
2024-10-14 #1 Power label change.... PDF updated
    [Tracker-Sheet.SchDoc]
2024-10-15 branding info pushed
    [400797.DRL, 400797.GBL, 400797.GBO, 400797.GBP, 400797.GBS, 400797.GM1, 400797.GTL, 400797.GTO]
2024-10-15 #1 PMIC v1.1 design - extra test points removed. Antenna symbol updated
    [Tracker-Sheet.SchDoc]
2024-10-15 #2 In Progress
    [Tracker-NB-IOT-v1.0.PcbDoc, Tracker-NB-IOT-v1.1.PcbDoc, Tracker-NB-IOT-v1.1.PrjPcb, Tracker-Sheet.SchDoc]
2024-10-16 #2 Tracker-NB-IOT-v1.1 Placement Completed
    [Tracker-NB-IOT-v1.1.PcbDoc, Tracker-Sheet.SchDoc]
2024-10-17 #2 v1.1 Completed
    [400797.PcbDoc, Tracker-NB-IOT-v1.1.PcbDoc, Tracker-NB-IOT-v1.1.PrjPcb, Tracker-Sheet.SchDoc]
2024-10-18 #1 Changes by Asim bhai validated. Comments removed. PDF updated.
    [Tracker-Sheet.SchDoc]
2024-10-18 #1 Test point added
    [Tracker-Sheet.SchDoc]
2024-10-18 #2 Completed and Fresh Deliverables Generated
    [Centriod File.csv, Pick Place for Tracker-NB-IOT-v1.1.csv, Tracker-NB-IOT-v1.1.DWG, Tracker-NB-IOT-v1.1.DXF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]
